Cascadealot/TestAPEN/UiNode.Display.20260117_212034.jpg

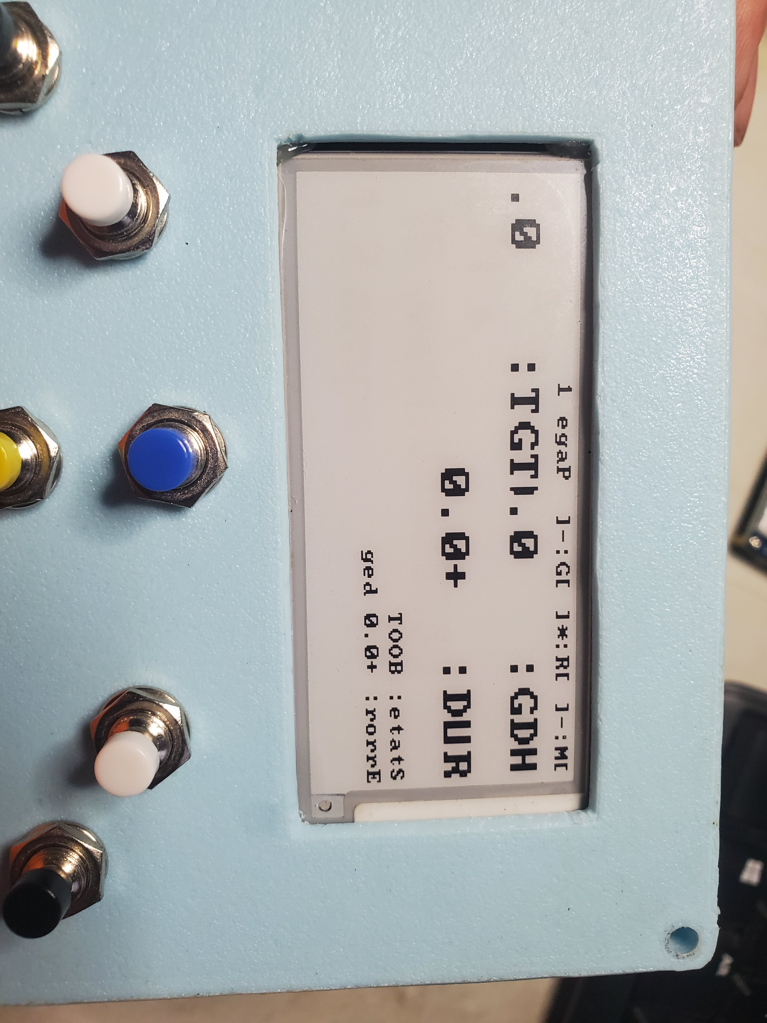
UiNode.Display.20260117_212034.jpg
