Cascadealot/TestAPEN/20260117_212520.jpg

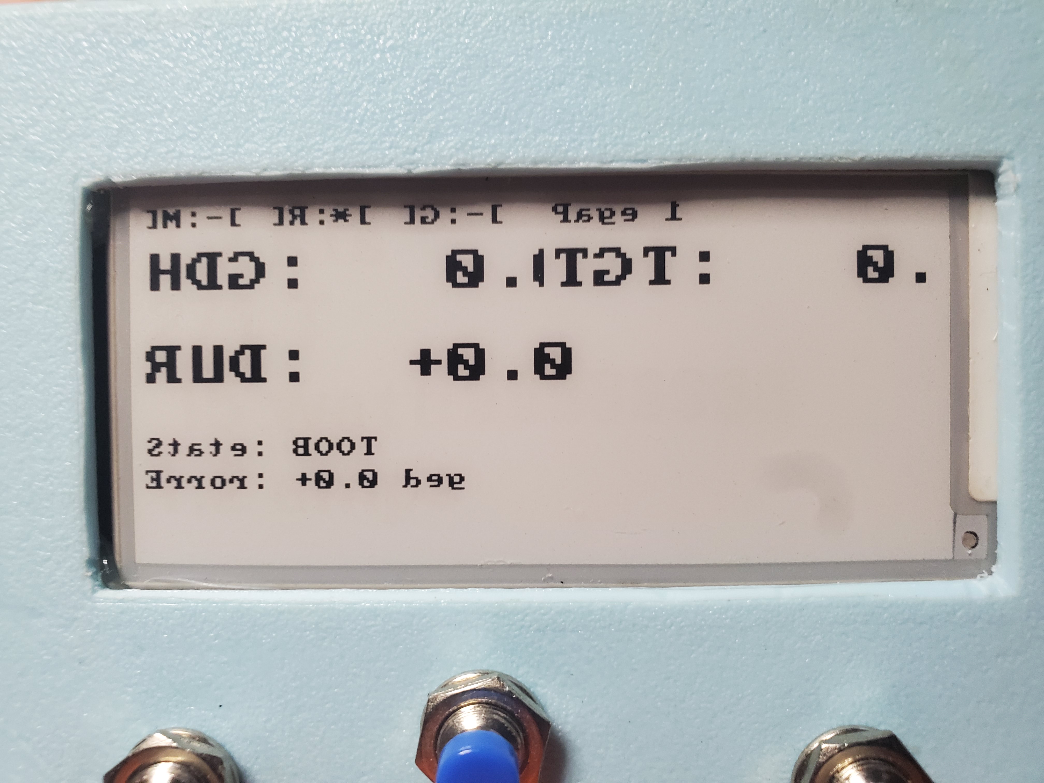
20260117_212520.jpg
