Cascadealot/TestAPEN/UiNode.Display.20260117_211544.jpg

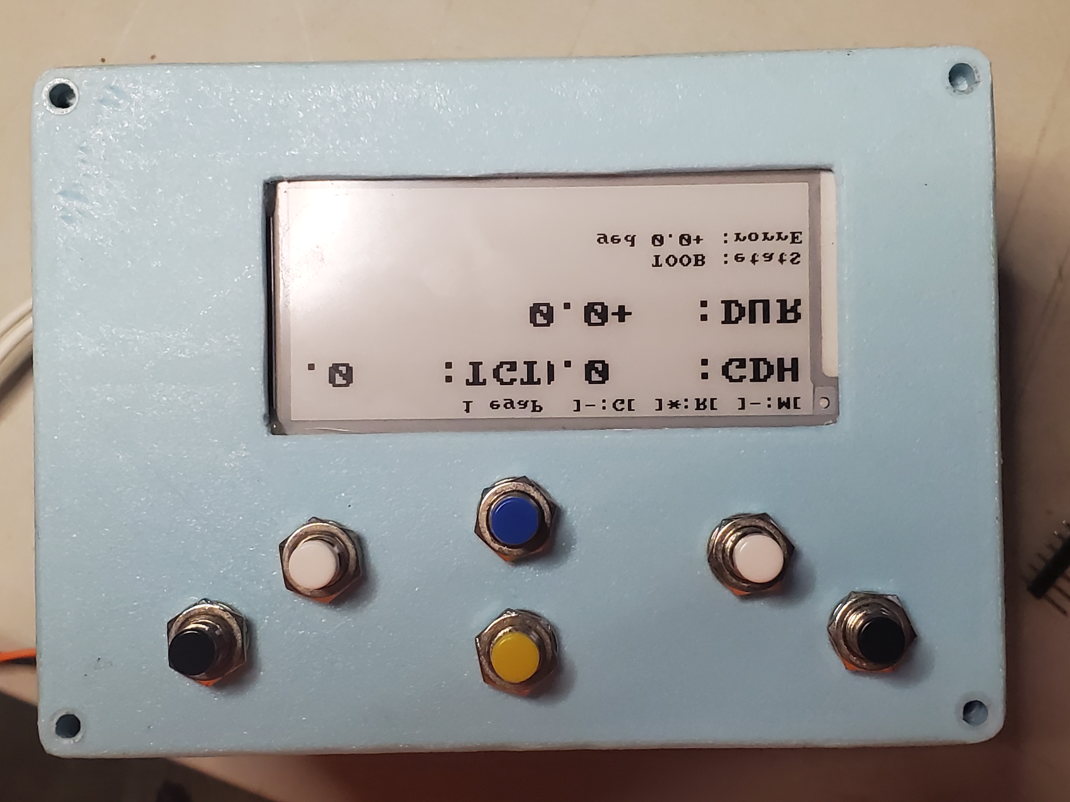
UiNode.Display.20260117_211544.jpg
