Cascadealot/TestAPEN/main/epaper_test.c

/**
 * @file epaper_test.c
 * @brief Interactive e-Paper Display Test with Console Commands
 *
 * Console commands for debugging e-paper display:
 *   ep clear    - Clear display to white
 *   ep black    - Fill display black
 *   ep pixel X Y - Draw single pixel at (X,Y)
 *   ep hline Y   - Draw horizontal line at Y
 *   ep vline X   - Draw vertical line at X
 *   ep rect      - Draw hollow rectangle 10px from edges
 *   ep text X Y MSG - Draw text at (X,Y)
 *   ep update    - Refresh display
 *   ep test      - Run test pattern
 *
 * Build: Enable CONFIG_TESTAPEN_EPAPER_TEST in menuconfig
 */

#include <stdio.h>
#include <string.h>
#include <stdlib.h>
#include <math.h>

#include "freertos/FreeRTOS.h"
#include "freertos/task.h"
#include "esp_log.h"
#include "esp_system.h"
#include "nvs_flash.h"

#include "network_manager.h"
#include "epaper.h"

static const char *TAG = "EPAPER_TEST";

// Test state
static float g_heading = 0.0f;
static int g_update_count = 0;
static bool g_use_partial = true;  // Enable partial refresh testing

// Heading display area (must be 8-pixel aligned for partial refresh)
// Using large font size 2 (16x16 pixels per char)
// "000.0" = 5 chars * 16 = 80 pixels wide, 16 pixels tall
// Centered horizontally: (296 - 80) / 2 = 108, round to multiple of 8 = 104
// Centered vertically: (128 - 16) / 2 = 56
#define HEADING_X       104
#define HEADING_Y       56
#define HEADING_W       88   // 80 + 8 padding, multiple of 8
#define HEADING_H       24   // 16 + 8 padding, multiple of 8

/**
 * @brief Clear a rectangular region to white
 */
static void clear_region(int x, int y, int w, int h) {
    for (int py = y; py < y + h && py < EPAPER_HEIGHT; py++) {
        for (int px = x; px < x + w && px < EPAPER_WIDTH; px++) {
            epaper_set_pixel(px, py, false);  // false = white
        }
    }
}

/**
 * @brief Draw the heading value
 */
static void draw_heading(float heading) {
    char buf[16];
    snprintf(buf, sizeof(buf), "%05.1f", heading);

    // Clear the heading area first
    clear_region(HEADING_X, HEADING_Y, HEADING_W, HEADING_H);

    // Draw heading with large font (size 2 = 16x16)
    epaper_draw_string(HEADING_X + 4, HEADING_Y + 4, buf, 2);
}

/**
 * @brief Draw static labels (only on full refresh)
 */
static void draw_static_content(void) {
    // Title at top
    epaper_draw_string(8, 4, "EPAPER PARTIAL TEST", 1);

    // Label above heading
    epaper_draw_string(HEADING_X + 16, HEADING_Y - 16, "HDG", 1);

    // Instructions at bottom
    epaper_draw_string(8, 108, "Partial refresh every 1s", 1);
    epaper_draw_string(8, 118, "Full refresh every 10 updates", 1);
}

/**
 * @brief Full display update (with flash)
 */
static void do_full_update(void) {
    ESP_LOGI(TAG, "=== FULL UPDATE ===");

    epaper_clear();
    draw_static_content();
    draw_heading(g_heading);

    uint32_t start = xTaskGetTickCount();
    epaper_update();
    uint32_t elapsed = (xTaskGetTickCount() - start) * portTICK_PERIOD_MS;

    ESP_LOGI(TAG, "Full update took %lu ms", elapsed);

    // Reset partial counter
    epaper_reset_partial();
}

/**
 * @brief Update display using partial refresh for heading area only
 */
static void do_partial_update(void) {
    g_update_count++;
    ESP_LOGI(TAG, "--- Partial update #%d, heading=%.1f ---", g_update_count, g_heading);

    // Update heading in framebuffer
    draw_heading(g_heading);

    // Use partial refresh for heading area
    uint32_t start = xTaskGetTickCount();
    epaper_update_partial(HEADING_X, HEADING_Y, HEADING_W, HEADING_H);
    uint32_t elapsed = (xTaskGetTickCount() - start) * portTICK_PERIOD_MS;

    ESP_LOGI(TAG, "Partial update took %lu ms", elapsed);
}

/**
 * @brief Console status task
 */
static void console_task(void *pvParameters) {
    ESP_LOGI(TAG, "Console ready - connect via telnet port 2323");
    ESP_LOGI(TAG, "OTA available at http://<ip>/update");

    // Just keep the task alive, network_manager handles console
    while (1) {
        vTaskDelay(pdMS_TO_TICKS(10000));

        // Print periodic status
        ESP_LOGI(TAG, "Status: heading=%.1f, updates=%d, partial=%s",
                 g_heading, g_update_count, g_use_partial ? "ON" : "OFF");
    }
}

/**
 * @brief Parse command into argc/argv
 */
static int parse_cmd(char *cmd_line, char **argv, int max_args) {
    int argc = 0;
    char *p = cmd_line;

    while (*p && argc < max_args) {
        // Skip whitespace
        while (*p == ' ' || *p == '\t') p++;
        if (!*p) break;

        // Start of token
        argv[argc++] = p;

        // Find end of token
        while (*p && *p != ' ' && *p != '\t') p++;
        if (*p) *p++ = '\0';
    }

    return argc;
}

/**
 * @brief Network manager command callback for e-paper testing
 */
static size_t ep_cmd_callback(const char *cmd_str, char *response, size_t response_size) {
    // Make a copy since we'll modify it
    char cmd_copy[256];
    strncpy(cmd_copy, cmd_str, sizeof(cmd_copy) - 1);
    cmd_copy[sizeof(cmd_copy) - 1] = '\0';

    // Parse into argc/argv
    char *argv[16];
    int argc = parse_cmd(cmd_copy, argv, 16);

    if (argc < 1) {
        return snprintf(response, response_size, "Empty command\r\n");
    }

    const char *cmd = argv[0];

    // Handle 'help' command
    if (strcmp(cmd, "help") == 0) {
        return snprintf(response, response_size,
            "E-Paper Test Commands:\r\n"
            "  clear       - Clear display to white\r\n"
            "  black       - Fill display black\r\n"
            "  pixel X Y   - Draw pixel at (X,Y)\r\n"
            "  hline Y     - Draw horizontal line at Y\r\n"
            "  vline X     - Draw vertical line at X\r\n"
            "  rect        - Draw hollow rectangle 10px from edges\r\n"
            "  fill X Y W H - Fill rectangle\r\n"
            "  text X Y MSG - Draw text\r\n"
            "  update      - Full refresh display\r\n"
            "  partial X Y W H - Partial refresh region\r\n"
            "  dirty       - Update only dirty region\r\n"
            "  heading VAL - Set heading (triggers partial update)\r\n"
            "  animate [N] - Animate heading N times (default 10)\r\n"
            "  test        - Run test pattern\r\n"
            "  info        - Show display info\r\n");
    }

    if (strcmp(cmd, "clear") == 0) {
        epaper_clear();
        return snprintf(response, response_size, "Display cleared to white\r\n");
    }
    else if (strcmp(cmd, "black") == 0) {
        epaper_clear_black();
        return snprintf(response, response_size, "Display filled black\r\n");
    }
    else if (strcmp(cmd, "pixel") == 0 && argc >= 3) {
        int x = atoi(argv[1]);
        int y = atoi(argv[2]);
        epaper_set_pixel(x, y, true);
        return snprintf(response, response_size, "Pixel set at (%d, %d)\r\n", x, y);
    }
    else if (strcmp(cmd, "hline") == 0 && argc >= 2) {
        int y = atoi(argv[1]);
        for (int x = 0; x < EPAPER_WIDTH; x++) {
            epaper_set_pixel(x, y, true);
        }
        return snprintf(response, response_size, "Horizontal line at y=%d\r\n", y);
    }
    else if (strcmp(cmd, "vline") == 0 && argc >= 2) {
        int x = atoi(argv[1]);
        for (int y = 0; y < EPAPER_HEIGHT; y++) {
            epaper_set_pixel(x, y, true);
        }
        return snprintf(response, response_size, "Vertical line at x=%d\r\n", x);
    }
    else if (strcmp(cmd, "rect") == 0) {
        // Hollow rectangle 10px from edges
        for (int x = 10; x < EPAPER_WIDTH - 10; x++) {
            epaper_set_pixel(x, 10, true);
            epaper_set_pixel(x, EPAPER_HEIGHT - 11, true);
        }
        for (int y = 10; y < EPAPER_HEIGHT - 10; y++) {
            epaper_set_pixel(10, y, true);
            epaper_set_pixel(EPAPER_WIDTH - 11, y, true);
        }
        return snprintf(response, response_size, "Rectangle drawn 10px from edges\r\n");
    }
    else if (strcmp(cmd, "fill") == 0 && argc >= 5) {
        int x = atoi(argv[1]);
        int y = atoi(argv[2]);
        int w = atoi(argv[3]);
        int h = atoi(argv[4]);
        for (int py = y; py < y + h; py++) {
            for (int px = x; px < x + w; px++) {
                epaper_set_pixel(px, py, true);
            }
        }
        return snprintf(response, response_size, "Filled rect at (%d,%d) size %dx%d\r\n", x, y, w, h);
    }
    else if (strcmp(cmd, "text") == 0 && argc >= 4) {
        int x = atoi(argv[1]);
        int y = atoi(argv[2]);
        epaper_draw_string(x, y, argv[3], 1);
        return snprintf(response, response_size, "Text '%s' at (%d,%d)\r\n", argv[3], x, y);
    }
    else if (strcmp(cmd, "update") == 0) {
        epaper_update();
        return snprintf(response, response_size, "Display updated (full refresh)\r\n");
    }
    else if (strcmp(cmd, "test") == 0) {
        epaper_test_pattern();
        return snprintf(response, response_size, "Test pattern complete\r\n");
    }
    else if (strcmp(cmd, "partial") == 0 && argc >= 5) {
        int x = atoi(argv[1]);
        int y = atoi(argv[2]);
        int w = atoi(argv[3]);
        int h = atoi(argv[4]);
        uint32_t start = xTaskGetTickCount();
        epaper_update_partial(x, y, w, h);
        uint32_t elapsed = (xTaskGetTickCount() - start) * portTICK_PERIOD_MS;
        return snprintf(response, response_size,
            "Partial refresh (%d,%d) %dx%d took %lu ms\r\n", x, y, w, h, elapsed);
    }
    else if (strcmp(cmd, "dirty") == 0) {
        uint32_t start = xTaskGetTickCount();
        epaper_update_dirty();
        uint32_t elapsed = (xTaskGetTickCount() - start) * portTICK_PERIOD_MS;
        return snprintf(response, response_size, "Dirty update took %lu ms\r\n", elapsed);
    }
    else if (strcmp(cmd, "heading") == 0 && argc >= 2) {
        g_heading = atof(argv[1]);
        if (g_heading < 0) g_heading = 0;
        if (g_heading >= 360) g_heading = fmod(g_heading, 360.0);
        do_partial_update();
        return snprintf(response, response_size, "Heading set to %.1f\r\n", g_heading);
    }
    else if (strcmp(cmd, "animate") == 0) {
        int count = 10;
        if (argc >= 2) count = atoi(argv[1]);
        if (count < 1) count = 1;
        if (count > 100) count = 100;

        // Do a full refresh first to establish clean baseline
        do_full_update();

        for (int i = 0; i < count; i++) {
            g_heading += 10.0f;
            if (g_heading >= 360.0f) g_heading -= 360.0f;
            ESP_LOGI(TAG, "[%d/%d] Heading: %.1f", i + 1, count, g_heading);
            do_partial_update();
            vTaskDelay(pdMS_TO_TICKS(500));
        }
        return snprintf(response, response_size,
            "Animation complete. %d partial refreshes, final heading: %.1f\r\n", count, g_heading);
    }
    else if (strcmp(cmd, "info") == 0) {
        return snprintf(response, response_size,
            "Display: %dx%d\r\n"
            "Framebuffer: %d bytes\r\n"
            "Heading region: (%d,%d) %dx%d\r\n"
            "Current heading: %.1f\r\n"
            "Update count: %d\r\n"
            "Partial mode: %s\r\n",
            EPAPER_WIDTH, EPAPER_HEIGHT,
            EPAPER_FB_SIZE,
            HEADING_X, HEADING_Y, HEADING_W, HEADING_H,
            g_heading,
            g_update_count,
            g_use_partial ? "ENABLED" : "DISABLED");
    }
    else {
        return snprintf(response, response_size, "Unknown command: %s\r\n", cmd);
    }

    return 0;
}


/**
 * @brief Application entry point
 */
void app_main(void) {
    ESP_LOGI(TAG, "========================================");
    ESP_LOGI(TAG, "  E-PAPER PARTIAL REFRESH TEST");
    ESP_LOGI(TAG, "  SSD1680 2.9\" 296x128");
    ESP_LOGI(TAG, "  159-byte LUT, 0x0F partial cmd");
    ESP_LOGI(TAG, "========================================");

    // Initialize NVS
    esp_err_t ret = nvs_flash_init();
    if (ret == ESP_ERR_NVS_NO_FREE_PAGES || ret == ESP_ERR_NVS_NEW_VERSION_FOUND) {
        ESP_ERROR_CHECK(nvs_flash_erase());
        ret = nvs_flash_init();
    }
    ESP_ERROR_CHECK(ret);

    // Initialize network (WiFi + OTA + telnet)
    ESP_LOGI(TAG, "Initializing network...");
    ret = network_manager_init(
        CONFIG_TESTAPEN_WIFI_SSID,
        CONFIG_TESTAPEN_WIFI_PASSWORD,
        "testapen-epaper-test",
        CONFIG_TESTAPEN_DEBUG_PORT
    );
    if (ret != ESP_OK) {
        ESP_LOGW(TAG, "Network init failed: %s (continuing anyway)", esp_err_to_name(ret));
    }

    // Wait for WiFi to connect
    vTaskDelay(pdMS_TO_TICKS(5000));

    // Initialize e-Paper display
    ESP_LOGI(TAG, "Initializing e-Paper display...");
    ret = epaper_init();
    if (ret != ESP_OK) {
        ESP_LOGE(TAG, "Failed to initialize e-Paper: %s", esp_err_to_name(ret));
        return;
    }

    ESP_LOGI(TAG, "Display initialized successfully");
    ESP_LOGI(TAG, "  Width:  %d", EPAPER_WIDTH);
    ESP_LOGI(TAG, "  Height: %d", EPAPER_HEIGHT);

    // Register command callback with network manager
    network_manager_set_command_callback(ep_cmd_callback);
    ESP_LOGI(TAG, "Console commands registered - use 'help' for commands");

    // Run initial test pattern
    ESP_LOGI(TAG, "Running initial test pattern...");
    epaper_test_pattern();

    // Create console status task
    xTaskCreate(console_task, "console", 2048, NULL, 3, NULL);

    ESP_LOGI(TAG, "Ready for interactive testing via telnet");
    ESP_LOGI(TAG, "Try: ep clear && ep hline 64 && ep update");
}
