Cascadealot/TestAPEN/(commit log)

2026-01-18 Initial commit: Fork of TestAP2 for ESP-NOW testing
    - Copied from TestAP2 autopilot project
    - Removed components/can_protocol/ (will be replaced with ESP-NOW)
    - Updated project name to testapen
    - Updated CLAUDE.md for ESP-NOW project context
    This fork replaces CAN bus communication with ESP-NOW wireless
    protocol to enable boat testing while CAN hardware issues are
    resolved in the original project.
    [partitions.csv]
2026-01-18 Implement ESP-NOW protocol replacing CAN bus
    - Create espnow_protocol component with same message structures as CAN
    - espnow_protocol.h: Message types, structures, API definitions
    - espnow_protocol.c: Init, send, receive, peer management
    - Migrate master_node.c: Replace CAN with ESP-NOW for heartbeats and commands
    - Migrate rudder_node.c: Replace CAN with ESP-NOW for heartbeats and commands
    - Migrate ui_node.c: Replace CAN with ESP-NOW for heartbeats and commands
    - Update cmd_console.c: Replace 'can' command with 'espnow' command
    - Update Kconfig.projbuild: Add ESP-NOW MAC configuration, remove CAN GPIOs
    - Update main.c: Remove CAN initialization (ESP-NOW init in node functions)
    - Update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
    [cmd_console.c, espnow_protocol.c, espnow_protocol.h, main.c, master_node.c, rudder_node.c, ui_node.c]
2026-01-18 Configure actual MAC addresses and fix component dependencies
    - Update Kconfig defaults with actual node MAC addresses:
    Master: 78:42:1C:6C:FA:58
    Rudder: 78:42:1C:6D:28:94
    UI: 78:42:1C:6B:E5:F0
    - Fix epaper CMakeLists.txt to use REQUIRES driver for dependency
    - Fix ble_manager CMakeLists.txt - always register with full deps
    - Enable size optimization and custom partition table for Master
    All three nodes successfully flashed via OTA and communicating.
2026-01-18 Add comprehensive test suite for TestAPEN
    Test suite covers all FSD v1.0.0 acceptance criteria and includes:
    Test Documentation (tests/TEST_SUITE.md):
    - Complete test case specifications for 100+ tests
    - Acceptance criteria mapping (AC-01 through AC-13)
    - Display, button, communication, motor, and error tests
    - Test environment setup and node IP/MAC references
    Automated Test Scripts (tests/scripts/):
    - test_common.sh: Shared test library functions
    - quick_validation.sh: Basic system health checks
    - comm_tests.sh: ESP-NOW communication verification
    - motor_tests.sh: Rudder motor control tests
    - error_tests.sh: Fault detection and recovery
    - display_tests.sh: OLED and e-Paper verification wi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
2026-01-18 Remove safety features from Rudder for hardware testing
    Temporarily disabled for on-water testing:
    - Stall detection (SAFE-001)
    - Drive timeout protection (SAFE-002)
    - Command timeout fault (ERR_ESPNOW_RX_TIMEOUT)
    - Master heartbeat timeout (ERR_HEARTBEAT_LOST)
    These features were triggering false positives and preventing
    motor operation. Hardware verified working via TestAP3.
    Safety features to be re-added incrementally once base
    functionality proven reliable.
    [rudder_node.c]
2026-01-19 Fix e-Paper display rendering with correct rotation and font
    - Fixed set_pixel coordinate transformation using Adafruit rotation 1 formula:
    native_x = 127 - y, native_y = x (for landscape 296x128 mode)
    - Fixed font bit extraction order: changed from (7-col) to (col)
    because font data has bit 0 as leftmost pixel
    - Added epaper_test_pattern() for display diagnostics
    - Rectangles and text now render correctly in landscape orientation
    Tested on SSD1680 2.9" display (296x128) with UI Node hardware.
    [epaper.c, epaper.h]
2026-01-19 Add button simulation via telnet and fix debug console
    Features:
    - Add 'btn' console command to simulate button presses (0-5)
    - Supports short and long press simulation
    - Enables automated testing without physical button access
    Fixes:
    - Fix telnet debug console not responding on UI node
    (increased task stack from 4096 to 8192 bytes)
    - Update branding from TestAP2 to TestAPEN in runtime strings
    Button mapping:
    0=DEC10 (-10°), 1=DEC1 (-1°), 2=ENGAGE, 3=MODE, 4=INC1 (+1°), 5=INC10 (+10°)
    [cmd_console.c, ui_node.c]
2026-01-19 Add partial refresh support for e-Paper display
    - Add 153-byte partial refresh LUT for fast (~0.4s) updates
    - Add epaper_update_partial(x,y,w,h) for region-based updates
    - Add epaper_update_dirty() for automatic dirty region updates
    - Add dirty region tracking in epaper_set_pixel()
    - Auto full refresh every 5 partial updates to prevent ghosting
    API additions:
    - epaper_update_partial() - update specific display region
    - epaper_update_dirty() - update tracked dirty region
    - epaper_reset_partial() - force next update to be full refresh
    - epaper_mark_dirty() - mark entire display as dirty
    Note: Current display_update() clears entire framebuffer, causing
    fallback to full refresh. Furt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
    [epaper.c, epaper.h, ui_node.c]
2026-01-19 Optimize e-Paper display to only redraw changed values
    Smart partial refresh for PAGE_AUTOPILOT:
    - Track previous display values (heading, target, rudder, state)
    - Only clear and redraw regions where values have changed
    - Use partial refresh for updated regions only
    - Fall back to full refresh on page change or connection state change
    Changes:
    - Add g_prev_display struct to track previous values
    - Add clear_region() helper to clear specific display areas
    - Add float_changed() helper for value comparison
    - Rewrite display_update() with smart redraw logic
    Performance improvement:
    - Partial updates now affect only changed regions (~0.4s)
    - Full refresh only on page change or first boot (~3s)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
2026-01-19 Add Self Validating Agents section to FSD (Section 14)
    New FSD section covering system self-validation mechanisms:
    14.1 Heartbeat Monitoring
    - Master/Rudder heartbeat sources and content
    - 8-byte message format specifications
    14.2 Timeout Detection and Fault Handling
    - Timeout thresholds (500ms heartbeat, 200ms command, etc.)
    - Fault response matrix by node
    14.3 State Validation Checks
    - Master node validations (heading, IMU, state transitions)
    - Rudder node validations (encoder, calibration, limits)
    - UI node validations (display, buttons, network)
    14.4 Self-Diagnostics
    - Console diagnostic commands by node
    - Runtime monitoring (memory, stacks, communication)
    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
2026-01-19 Document TestAPEN2 Arduino UI Node creation
    Created new Arduino-based UI Node project (TestAPEN2) to replace
    the ESP-IDF e-paper implementation that had display issues.
    - GxEPD2 library for reliable 2.9" SSD1680 e-paper support
    - Telnet debug console on port 2323
    - HTTP OTA updates on port 80
    - ESP-NOW compatible with TestAPEN Master/Rudder nodes
2026-01-20 Fix e-Paper SSD1680 driver: row-major framebuffer with correct rotation
    Root cause: Framebuffer was organized column-major but SSD1680 expects
    row-major layout. This caused all text/graphics to render as garbage
    vertical stripes.
    Fix based on research of working implementations (GxEPD2, ESPHome,
    Waveshare):
    - Framebuffer: row-major layout
    byte_idx = (rotated_x / 8) + rotated_y * 16
    - Bit order: MSB-first (leftmost pixel = bit 7)
    bit_mask = 0x80 >> (rotated_x % 8)
    - Rotation: GxEPD2 rotation 1 for landscape mode
    rotated_x = 127 - y
    rotated_y = x
    - LUT: Updated to 159-byte format for SSD1680 partial refresh
    Tested: Border rectangle, filled squares, and text ("HELLO",
    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
    [epaper.c, epaper_test.c]
2026-01-20 Add e-paper partial refresh and test plan
    - Integrated e-paper driver into ui_node.c with partial refresh
    - Added comprehensive test plan (docs/TestAPEN-TestPlan.md)
    - Updated epaper_test.c with network command callback
    - All 11 automated tests passing
    Test plan covers:
    - Network connectivity (3 tests)
    - ESP-NOW communication (2 tests)
    - Master/Rudder node functions (4 tests)
    - Display verification (1 test)
    - Engage/disengage cycle (1 test)
2026-01-20 Document comprehensive test results - 45/45 tests passing
    Test summary:
    - Network, ESP-NOW, Master, Rudder: All verified
    - UI display with partial refresh working
    - Button input and heading adjustment verified
    - Autopilot engagement from Master and UI buttons
    - State machine and OTA endpoints confirmed
2026-01-20 Update FSD v1.1.0: ESP-NOW protocol, UI Node, e-Paper display
    Major FSD revision reflecting actual TestAPEN implementation:
    - ESP-NOW wireless replaces CAN bus throughout
    - Add UI Node (3rd node) with e-Paper display + buttons
    - Document button simulation for automated testing
    - Add partial refresh strategy for e-Paper
    - Include network configuration (IPs, telnet, OTA)
    - Create FSD generation instructions for AI assistants
    FSD now accurately reflects the tri-node ESP-NOW architecture.
2026-01-20 Update context for project pause - all systems operational
    Quick resume info:
    - 45/45 tests passing
    - All 3 nodes communicating via ESP-NOW
    - FSD v1.1.0 current
    - Ready for boat testing
2026-01-24 Fix credentials.h include path in UiNode
    [UiNode.ino]
2026-01-24 Use direct epaper_update_partial() for display updates
    Replace epaper_update_dirty() with direct epaper_update_partial() calls
    for each display region (HDG, TGT, RUD, State, Fault). This provides
    faster, more targeted partial refreshes and avoids the 50% threshold
    that triggers full refresh.
    - Define region coordinates as macros for clarity
    - Each value region is updated independently with its own partial refresh
    - Reduces display update latency for autopilot page
    [ui_node.c]
2026-01-24 Complete TESTAP2 → TESTAPEN rename and hardware config updates
    Critical changes:
    - Renamed all CONFIG_TESTAP2_* to CONFIG_TESTAPEN_* across codebase
    - Updated all source file references from TestAP2 to TestAPEN
    - Fixed motor driver pins: DIR=25, PWM=26 (hardware rebuild)
    - Made BLE manager conditional (Master node only)
    - Updated UI node partial refresh with state/mode display
    This commit resolves naming confusion that caused cross-project
    contamination issues over multiple development sessions.
    [EPartial.ino, as5600.c, as5600.h, autopilot_common.c, autopilot_common.h, ble_manager.c, ble_manager.h, cmd_console.c]
2026-01-24 Fix Master node build: restore working config from pre-rename state
    Root Cause Analysis:
    - Commit 1ae571c (TESTAP2→TESTAPEN rename) inadvertently changed:
    - Partition table: CUSTOM (1.5MB) → SINGLE_APP (1MB)
    - Bluetooth: Enabled → Disabled
    - WiFi credentials: Lost due to variable prefix change
    - These changes broke Master node builds (BLE+WiFi won't fit in 1MB)
    Fixes Applied:
    1. sdkconfig: Restore CONFIG_PARTITION_TABLE_CUSTOM=y (1.5MB OTA partitions)
    2. sdkconfig: Restore CONFIG_BT_ENABLED=y with NimBLE settings
    3. sdkconfig: Restore CONFIG_COMPILER_OPTIMIZATION_SIZE=y for IRAM fit
    4. sdkconfig: Fix WiFi credentials (Boathouse24)
    5. sdkconfig: Set CONFIG_TESTAPEN_NODE_MASTER=y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
2026-01-24 Implement resilient initialization order for Rudder node
    Reorders initialization to ensure OTA and telnet debug are always
    available, even when sensors fail:
    Phase 1: I2C + Display (for boot status)
    Phase 2: State Machine
    Phase 3: Parameter Store
    Phase 4: Network/WiFi + Console (critical for OTA/debug)
    Phase 5: ESP-NOW (before sensors)
    Phase 6: Motor Driver (before sensors, won't run without feedback)
    Phase 7: AS5600 Encoder (last - failures don't block debug access)
    Phase 8: Summary Screen (shows fault status if any)
    Phase 9: Tasks (always created, even if faulted)
    Key changes:
    - Remove early returns on sensor failure
    - Add g_as5600_available flag for graceful degradation
    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
    [rudder_node.c]
2026-01-24 Update claude-progress.txt with Sessions 23-24
    Session 23: Master node build recovery (partition, BT, WiFi fixes)
    Session 24: Rudder node resilient initialization
2026-01-24 Add FSD differences document v0.0.1
    Systematic comparison of FSD v1.1.0 against current codebase:
    Key differences identified:
    - Motor GPIO pins swapped (PWM=26, DIR=25 vs FSD spec)
    - E-Paper GPIO pins differ from FSD
    - Task_Network added to all nodes (not in FSD)
    - Resilient initialization for Rudder node (new feature)
    - Additional console commands not documented
    - Magnetometer calibration BLE commands not documented
    - Additional parameters in param_store
    Includes prioritized list of required FSD updates.
